zuidec/discostick_cyclic/kicad/z_cyclic.kicad_pcb

## KiCad design kicad/z_cyclic.kicad_pcb (2025-07-11)

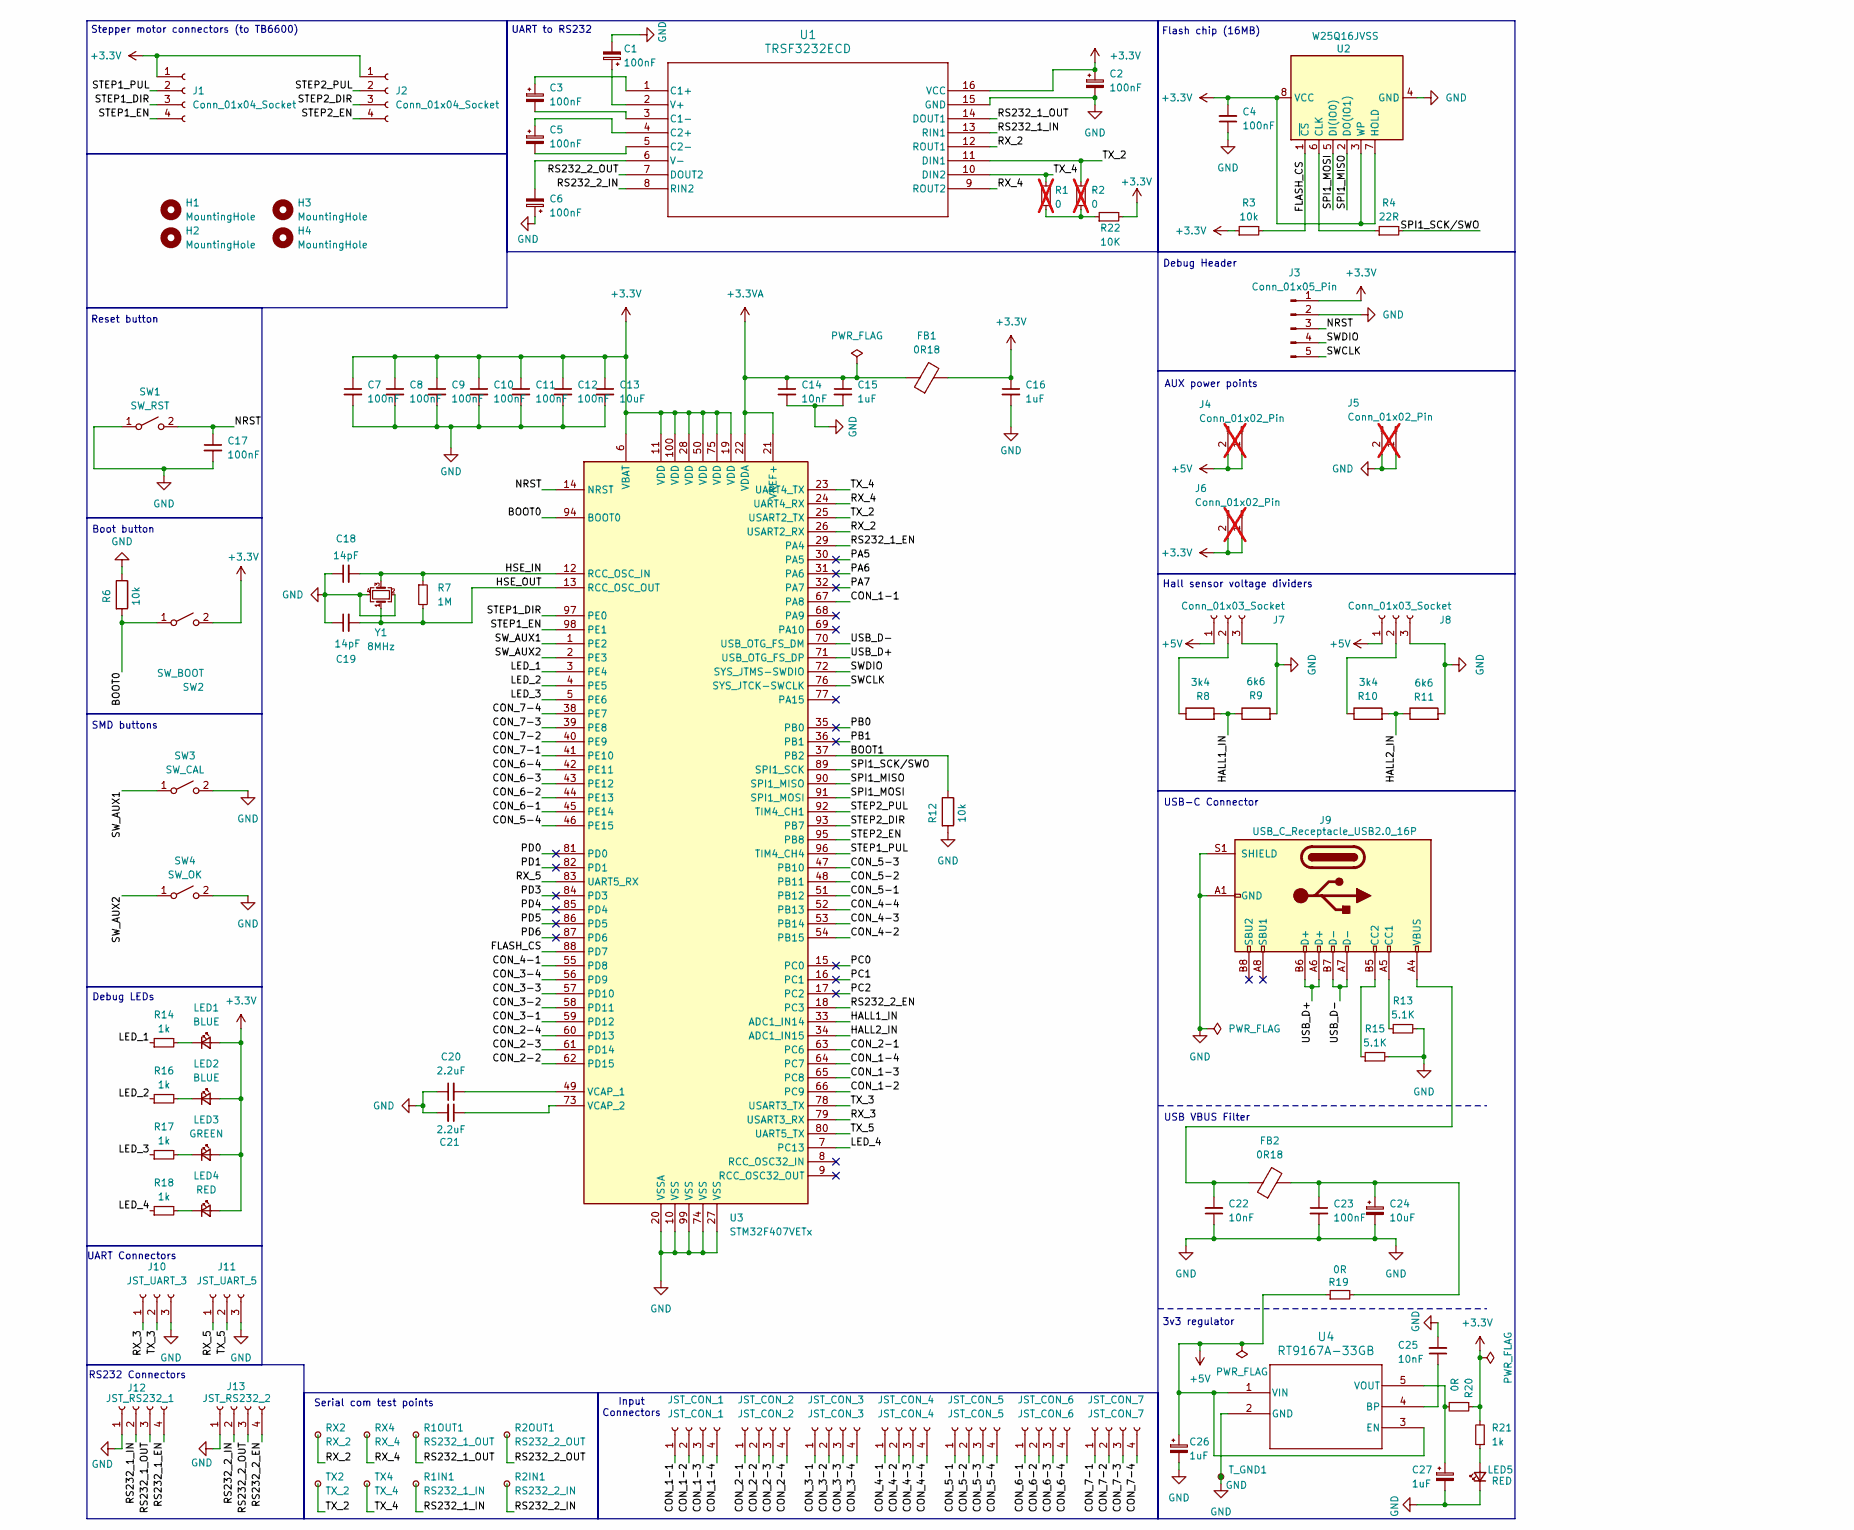
[picture p1: schematic z_cyclic.kicad_sch, distostick_controller, part in row 1, column 1]

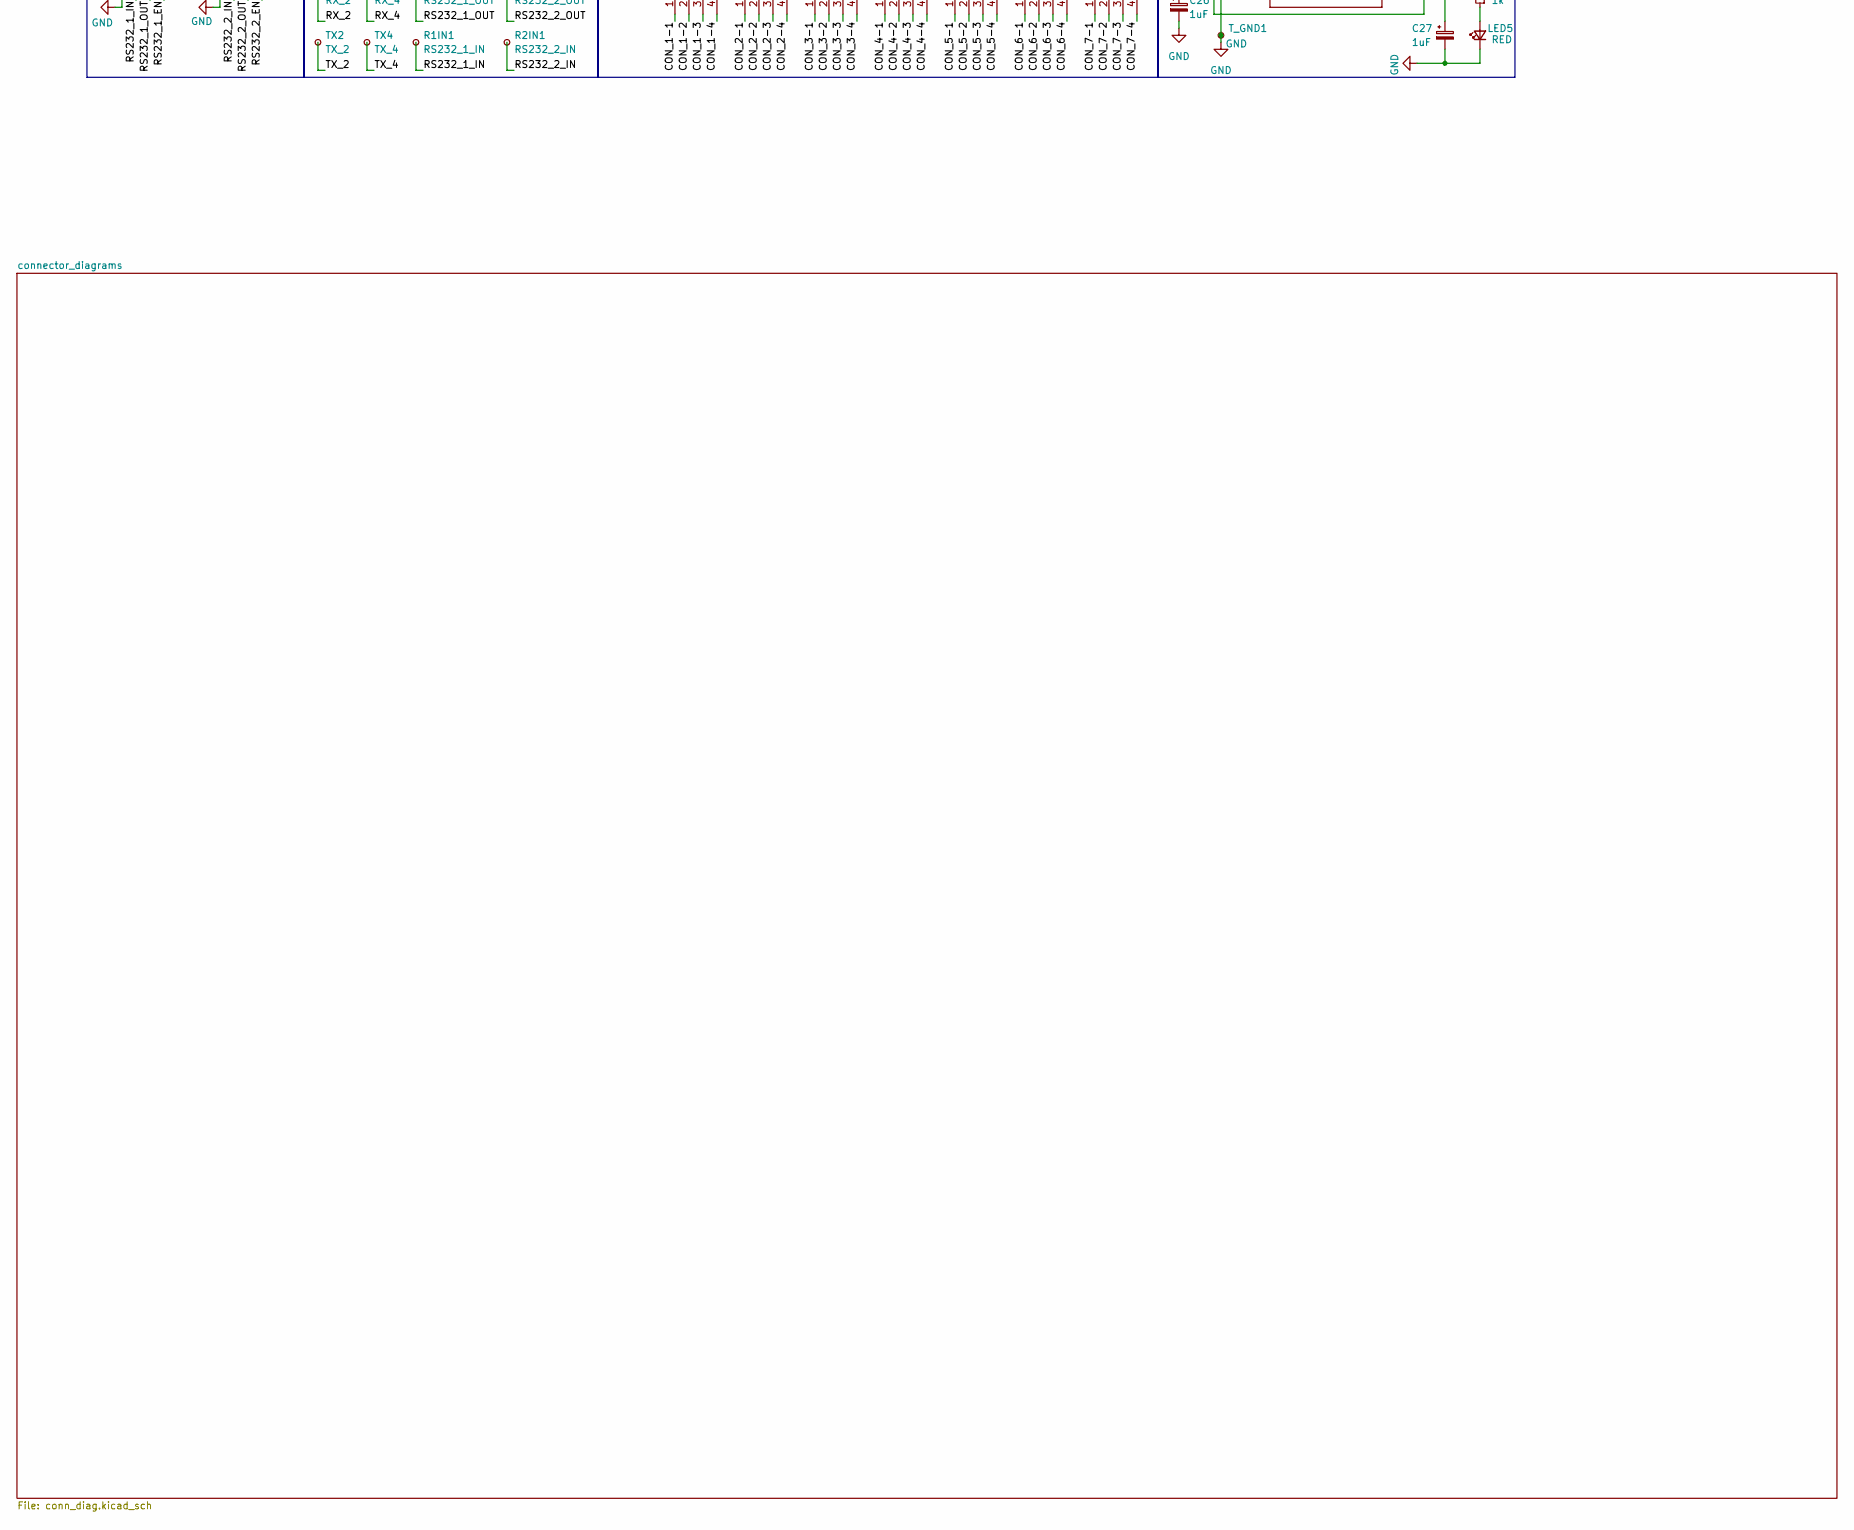
[picture p2: schematic z_cyclic.kicad_sch, distostick_controller, part in row 2, column 1]

Parts:
C1, C2, C3, C4, C5, C6, C7, C8, C9, C10, C11, C12, C17, C23: 100nF; C_0402_1005Metric
C13, C24: 10uF; C_0603_1608Metric
C14, C22, C25: 10nF; C_0402_1005Metric
C15, C16, C26: 1uF; C_0402_1005Metric
C18, C19: 14pF; C_0402_1005Metric
C20, C21: 2.2uF; C_0402_1005Metric
C27: 1uF; C_0603_1608Metric
FB1, FB2: 0R18; R_0805_2012Metric
H1, H2, H3, H4: MountingHole; MountingHole_3.2mm_M3
J1, J2: Conn_01x04_Socket; JST_EH_B4B-EH-A_1x04_P2.50mm_Vertical
J3: Conn_01x05_Pin; PinHeader_1x05_P2.54mm_Vertical
J4, J5, J6: Conn_01x02_Pin; PinSocket_1x02_P2.54mm_Vertical; not fitted
J7, J8: Conn_01x03_Socket; JST_EH_B3B-EH-A_1x03_P2.50mm_Vertical
J9: USB_C_Receptacle_USB2.0_16P; USB_C_Receptacle_G-Switch_GT-USB-7010ASV
J10: JST_UART_3; JST_EH_B3B-EH-A_1x03_P2.50mm_Vertical
J11: JST_UART_5; JST_EH_B3B-EH-A_1x03_P2.50mm_Vertical
J12: JST_RS232_1; JST_EH_B4B-EH-A_1x04_P2.50mm_Vertical
J13: JST_RS232_2; JST_EH_B4B-EH-A_1x04_P2.50mm_Vertical
JST_CON_1: JST_CON_1; JST_EH_B4B-EH-A_1x04_P2.50mm_Vertical
JST_CON_2: JST_CON_2; JST_EH_B4B-EH-A_1x04_P2.50mm_Vertical
JST_CON_3: JST_CON_3; JST_EH_B4B-EH-A_1x04_P2.50mm_Vertical
JST_CON_4: JST_CON_4; JST_EH_B4B-EH-A_1x04_P2.50mm_Vertical
JST_CON_5: JST_CON_5; JST_EH_B4B-EH-A_1x04_P2.50mm_Vertical
JST_CON_6: JST_CON_6; JST_EH_B4B-EH-A_1x04_P2.50mm_Vertical
JST_CON_7: JST_CON_7; JST_EH_B4B-EH-A_1x04_P2.50mm_Vertical
LED1, LED2: BLUE; LED_0402_1005Metric
LED3: GREEN; LED_0402_1005Metric
LED4, LED5: RED; LED_0402_1005Metric
R1, R2: 0; R_0805_2012Metric_Pad1.20x1.40mm_HandSolder; not fitted
R1IN1: RS232_1_IN; TestPoint_Pad_D1.0mm
R1OUT1: RS232_1_OUT; TestPoint_Pad_D1.0mm
R2IN1: RS232_2_IN; TestPoint_Pad_D1.0mm
R2OUT1: RS232_2_OUT; TestPoint_Pad_D1.0mm
R3, R6, R12: 10k; R_0402_1005Metric
R4: 22R; R_0402_1005Metric
R7: 1M; R_0402_1005Metric
R8, R10: 3k4; R_0402_1005Metric
R9, R11: 6k6; R_0402_1005Metric
R13, R15: 5.1K; R_0402_1005Metric
R14, R16, R17, R18, R21: 1k; R_0402_1005Metric
R19, R20: 0R; SolderJumper-2_P1.3mm_Open_TrianglePad1.0x1.5mm
R22: 10K; R_0402_1005Metric
RX2: RX_2; TestPoint_Pad_D1.0mm
RX4: RX_4; TestPoint_Pad_D1.0mm
SW1: SW_RST; SW_SPST_B3U-1000P; PARTREV B
SW2: SW_BOOT; SW_SPST_B3U-1000P; PARTREV B
SW3: SW_CAL; SW_SPST_B3U-1000P; PARTREV B
SW4: SW_OK; SW_SPST_B3U-1000P; PARTREV B
TX2: TX_2; TestPoint_Pad_D1.0mm
TX4: TX_4; TestPoint_Pad_D1.0mm
T_GND1: GND; TestPoint_Pad_1.5x1.5mm
U1: TRSF3232ECD; D16
U2: W25Q16JVSS; SOIC-8_5.23x5.23mm_P1.27mm
U3: STM32F407VETx; LQFP-100_14x14mm_P0.5mm
U4: RT9167A-33GB; SOIC_A-33GB_RIT
Y1: 8MHz; Crystal_SMD_3225-4Pin_3.2x2.5mm

Connections:
+3.3V: C2.1, C4.2, C7.1, C8.1, C9.1, C10.1, C11.1, C12.1, C13.1, C16.1, FB1.2, J1.1, J2.1, J3.1, J6.1, J6.2, LED1.2 (A), LED2.2 (A), LED3.2 (A), LED4.2 (A), R3.1, R20.1, R21.2, R22.2, SW2.2 (B), U1.16 (VCC), U2.3 (WP), U2.7 (HOLD), U2.8 (VCC), U3.6 (VBAT), U3.11 (VDD), U3.19 (VDD), U3.28 (VDD), U3.50 (VDD), U3.75 (VDD), U3.100 (VDD)
+3.3VA: C14.1, C15.1, FB1.1, U3.21 (VREF+), U3.22 (VDDA)
+5V: C26.1, J4.1, J4.2, J7.1, J8.1, R19.1, U4.1 (VIN), U4.3 (EN)
/BOOT0: R6.2, SW2.1 (A), U3.94 (BOOT0)
/BOOT1: R12.1, U3.37 (PB2)
/CON_1-1: JST_CON_1.1, U3.67 (PA8)
/CON_1-2: JST_CON_1.2, U3.66 (PC9)
/CON_1-3: JST_CON_1.3, U3.65 (PC8)
/CON_1-4: JST_CON_1.4, U3.64 (PC7)
/CON_2-1: JST_CON_2.1, U3.63 (PC6)
/CON_2-2: JST_CON_2.2, U3.62 (PD15)
/CON_2-3: JST_CON_2.3, U3.61 (PD14)
/CON_2-4: JST_CON_2.4, U3.60 (PD13)
/CON_3-1: JST_CON_3.1, U3.59 (PD12)
/CON_3-2: JST_CON_3.2, U3.58 (PD11)
/CON_3-3: JST_CON_3.3, U3.57 (PD10)
/CON_3-4: JST_CON_3.4, U3.56 (PD9)
/CON_4-1: JST_CON_4.1, U3.55 (PD8)
/CON_4-2: JST_CON_4.2, U3.54 (PB15)
/CON_4-3: JST_CON_4.3, U3.53 (PB14)
/CON_4-4: JST_CON_4.4, U3.52 (PB13)
/CON_5-1: JST_CON_5.1, U3.51 (PB12)
/CON_5-2: JST_CON_5.2, U3.48 (PB11)
/CON_5-3: JST_CON_5.3, U3.47 (PB10)
/CON_5-4: JST_CON_5.4, U3.46 (PE15)
/CON_6-1: JST_CON_6.1, U3.45 (PE14)
/CON_6-2: JST_CON_6.2, U3.44 (PE13)
/CON_6-3: JST_CON_6.3, U3.43 (PE12)
/CON_6-4: JST_CON_6.4, U3.42 (PE11)
/CON_7-1: JST_CON_7.1, U3.41 (PE10)
/CON_7-2: JST_CON_7.2, U3.40 (PE9)
/CON_7-3: JST_CON_7.3, U3.39 (PE8)
/CON_7-4: JST_CON_7.4, U3.38 (PE7)
/FLASH_CS: R3.2, U2.1 (~CS), U3.88 (PD7)
/HALL1_IN: R8.2, R9.1, U3.33 (ADC1_IN14)
/HALL2_IN: R10.2, R11.1, U3.34 (ADC1_IN15)
/HSE_IN: C18.2, R7.1, U3.12 (RCC_OSC_IN), Y1.3
/HSE_OUT: C19.2, R7.2, U3.13 (RCC_OSC_OUT), Y1.1
/LED_1: R14.1, U3.3 (PE4)
/LED_2: R16.1, U3.4 (PE5)
/LED_3: R17.1, U3.5 (PE6)
/LED_4: R18.1, U3.7 (PC13)
/NRST: C17.1, J3.3, SW1.2 (B), U3.14 (NRST)
/PA5: U3.30 (PA5)
/PA6: U3.31 (PA6)
/PA7: U3.32 (PA7)
/PB0: U3.35 (PB0)
/PB1: U3.36 (PB1)
/PC0: U3.15 (PC0)
/PC1: U3.16 (PC1)
/PC2: U3.17 (PC2)
/PD0: U3.81 (PD0)
/PD1: U3.82 (PD1)
/PD3: U3.84 (PD3)
/PD4: U3.85 (PD4)
/PD5: U3.86 (PD5)
/PD6: U3.87 (PD6)
/RS232_1_EN: J12.4, U3.29 (PA4)
/RS232_1_IN: J12.2, R1IN1.1, U1.13 (RIN1)
/RS232_1_OUT: J12.3, R1OUT1.1, U1.14 (DOUT1)
/RS232_2_EN: J13.4, U3.18 (PC3)
/RS232_2_IN: J13.2, R2IN1.1, U1.8 (RIN2)
/RS232_2_OUT: J13.3, R2OUT1.1, U1.7 (DOUT2)
/RX_2: RX2.1, U1.12 (ROUT1), U3.26 (USART2_RX)
/RX_3: J10.1, U3.79 (USART3_RX)
/RX_4: RX4.1, U1.9 (ROUT2), U3.24 (UART4_RX)
/RX_5: J11.1, U3.83 (UART5_RX)
/SPI1_MISO: U2.2 (DO(IO1)), U3.90 (SPI1_MISO)
/SPI1_MOSI: U2.5 (DI(IO0)), U3.91 (SPI1_MOSI)
/SPI1_SCK/SWO: R4.2, U3.89 (SPI1_SCK)
/STEP1_DIR: J1.3, U3.97 (PE0)
/STEP1_EN: J1.4, U3.98 (PE1)
/STEP1_PUL: J1.2, U3.96 (TIM4_CH4)
/STEP2_DIR: J2.3, U3.93 (PB7)
/STEP2_EN: J2.4, U3.95 (PB8)
/STEP2_PUL: J2.2, U3.92 (TIM4_CH1)
/SWCLK: J3.5, U3.76 (SYS_JTCK-SWCLK)
/SWDIO: J3.4, U3.72 (SYS_JTMS-SWDIO)
/SW_AUX1: SW3.1 (A), U3.1 (PE2)
/SW_AUX2: SW4.1 (A), U3.2 (PE3)
/TX_2: R2.1, TX2.1, U1.11 (DIN1), U3.25 (USART2_TX)
/TX_3: J10.2, U3.78 (USART3_TX)
/TX_4: R1.1, TX4.1, U1.10 (DIN2), U3.23 (UART4_TX)
/TX_5: J11.2, U3.80 (UART5_TX)
/USB_D+: J9.A6 (D+), J9.B6 (D+), U3.71 (USB_OTG_FS_DP)
/USB_D-: J9.A7 (D-), J9.B7 (D-), U3.70 (USB_OTG_FS_DM)
GND: C1.2, C2.2, C4.1, C6.1, C7.2, C8.2, C9.2, C10.2, C11.2, C12.2, C13.2, C14.2, C15.2, C16.2, C17.2, C18.1, C19.1, C20.1, C21.2, C22.1, C23.2, C24.2, C25.2, C26.2, C27.2, J3.2, J5.1, J5.2, J7.3, J8.3, J9.A1 (GND), J9.A12 (GND), J9.B1 (GND), J9.B12 (GND), J9.S1 (SHIELD), J10.3, J11.3, J12.1, J13.1, LED5.1 (K), R6.1, R9.2, R11.2, R12.2, R13.2, R15.2, SW1.1 (A), SW3.2 (B), SW4.2 (B), T_GND1.1, U1.15 (GND), U2.4 (GND), U3.10 (VSS), U3.20 (VSSA), U3.27 (VSS), U3.74 (VSS), U3.99 (VSS), U4.2 (GND), Y1.2, Y1.4
unnamed: C22.2, FB2.1, J9.A4 (VBUS), J9.A9 (VBUS), J9.B4 (VBUS), J9.B9 (VBUS)
unnamed: C23.1, C24.1, FB2.2, R19.2
unnamed: J7.2, R8.1
unnamed: J8.2, R10.1
unnamed: J9.A5 (CC1), R13.1
unnamed: J9.B5 (CC2), R15.1
unnamed: LED1.1 (K), R14.2
unnamed: LED2.1 (K), R16.2
unnamed: LED3.1 (K), R17.2
unnamed: LED4.1 (K), R18.2
unnamed: LED5.2 (A), R21.1
unnamed: R1.2, R2.2, R22.1
unnamed: C3.1, U1.1 (C1+)
unnamed: C3.2, U1.3 (C1-)
unnamed: C5.1, U1.4 (C2+)
unnamed: C5.2, U1.5 (C2-)
unnamed: C1.1, U1.2 (V+)
unnamed: C6.2, U1.6 (V-)
unnamed: R4.1, U2.6 (CLK)
unnamed: C20.2, U3.49 (VCAP_1)
unnamed: C21.1, U3.73 (VCAP_2)
unnamed: C25.1, U4.4 (BP)
unnamed: C27.1, R20.2, U4.5 (VOUT)

Notes on the sheet:
Stepper motor connectors (to TB6600)
Reset button
RS232 Connectors
SMD buttons
Boot button
UART to RS232
Serial com test points
Flash chip (16MB)
AUX power points
3v3 regulator
USB VBUS Filter
USB-C Connector
Debug LEDs
UART Connectors
Input Connectors
Hall sensor voltage dividers
Debug Header

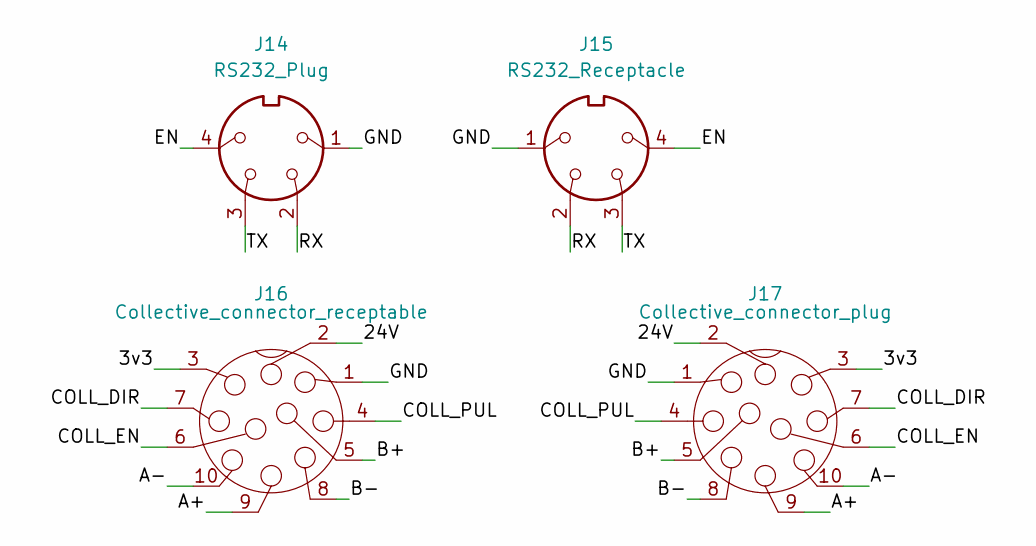
[picture p3: schematic conn_diag.kicad_sch]

Parts:
J14: RS232_Plug
J15: RS232_Receptacle
J16: Collective_connector_receptable
J17: Collective_connector_plug

Connections:
unnamed: J14.1, J15.1, J16.1, J17.1
unnamed: J14.2, J15.2
unnamed: J14.3, J15.3
unnamed: J14.4, J15.4
unnamed: J16.2, J17.2
unnamed: J16.3, J17.3
unnamed: J16.4, J17.4
unnamed: J16.5, J17.5
unnamed: J16.6, J17.6
unnamed: J16.7, J17.7
unnamed: J16.8, J17.8
unnamed: J16.9, J17.9
unnamed: J16.10, J17.10

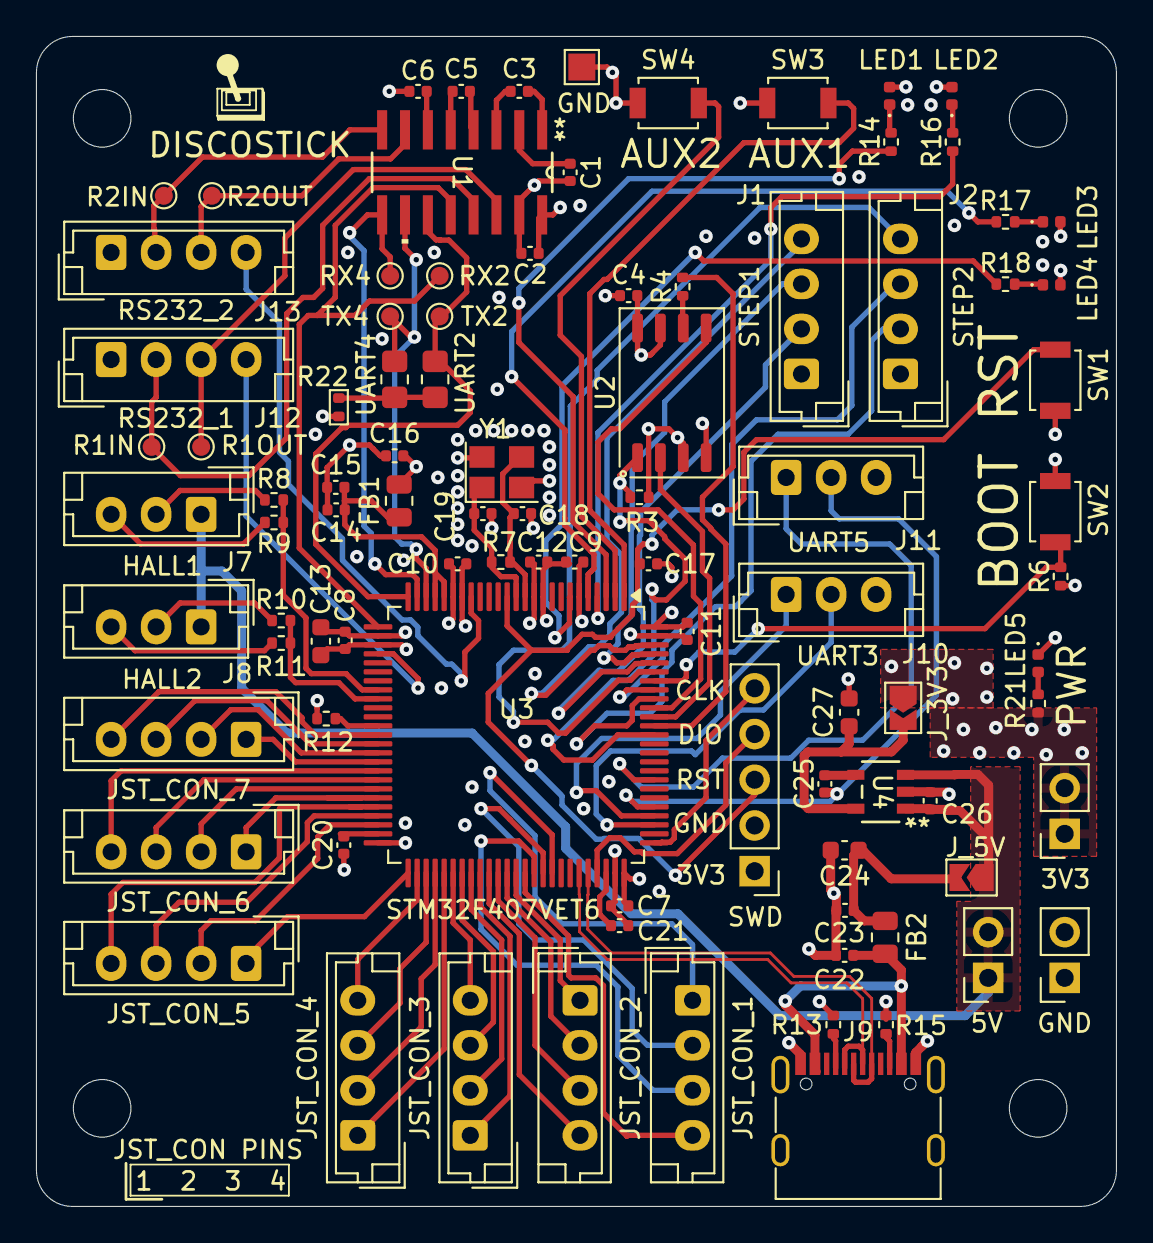
[picture p4: board z_cyclic.kicad_pcb from above]

Board: 4 copper layers, 60.0 x 65.0 mm, 97 parts (0 on the bottom side), 96 nets.
