zuidec/discostick_cyclic/kicad/backup.z_cyclic.kicad_pcb

## KiCad design kicad/backup.z_cyclic.kicad_pcb (2025-07-11)

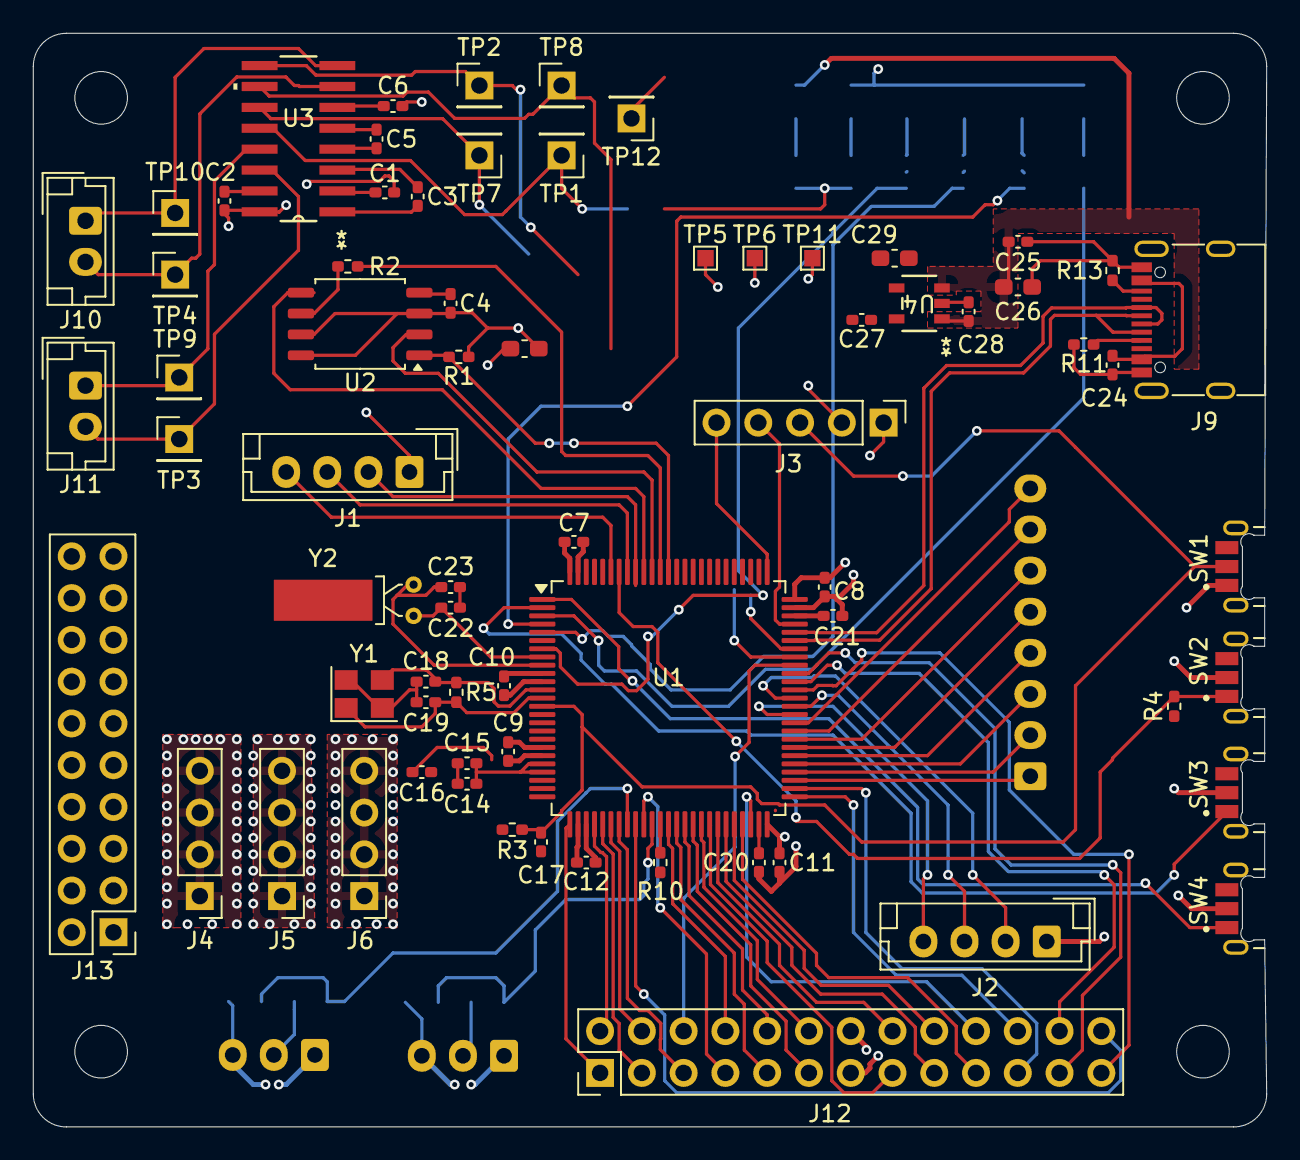
[picture p5: board backup.z_cyclic.kicad_pcb from above]

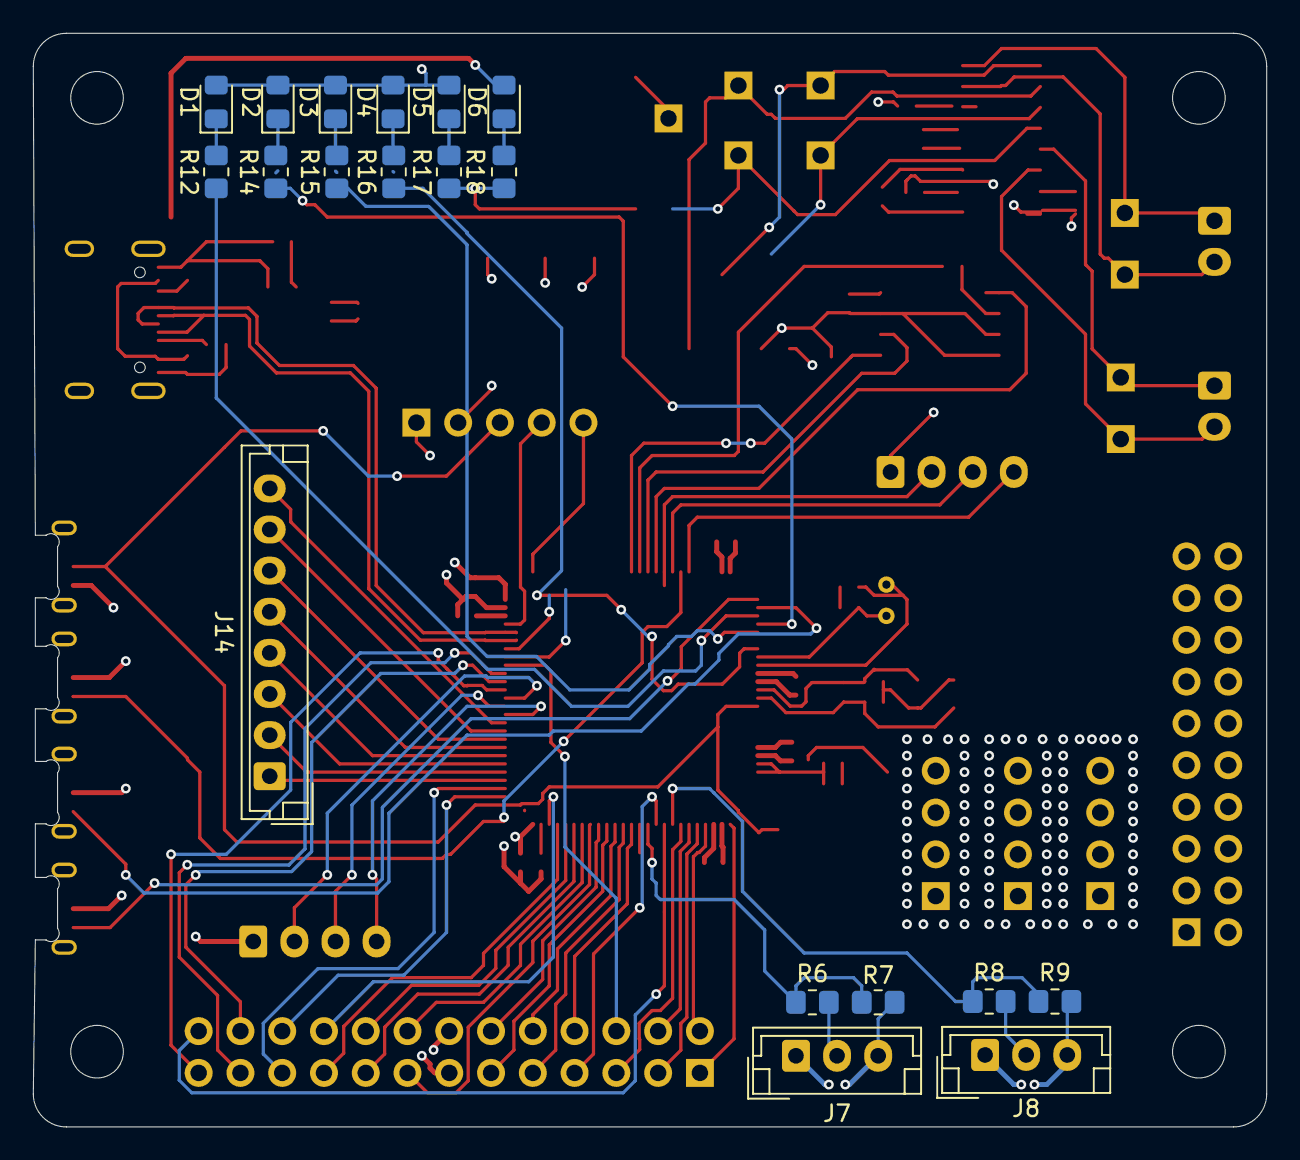
[picture p6: board backup.z_cyclic.kicad_pcb from below]

Board: 4 copper layers, 75.0 x 66.5 mm, 93 parts (19 on the bottom side), 112 nets.

Parts:
C1, C2, C3, C4, C5, C6, C7, C8, C9, C10, C11, C12, C17, C25: 100nF; C_0402_1005Metric_Pad0.74x0.62mm_HandSolder
C13, C26: 10uF; C_0603_1608Metric_Pad1.08x0.95mm_HandSolder
C14, C24: 10nF; C_0402_1005Metric_Pad0.74x0.62mm_HandSolder
C15, C16, C28: 1uF; C_0402_1005Metric_Pad0.74x0.62mm_HandSolder
C18, C19: 14pF; C_0402_1005Metric_Pad0.74x0.62mm_HandSolder
C20, C21: 2.2uF; C_0402_1005Metric_Pad0.74x0.62mm_HandSolder
C22, C23: 1.5pF; C_0402_1005Metric_Pad0.74x0.62mm_HandSolder
C27: 10uF; C_0402_1005Metric_Pad0.74x0.62mm_HandSolder
C29: 1uF; C_0603_1608Metric_Pad1.08x0.95mm_HandSolder
D1, D2: BLUE; LED_0805_2012Metric_Pad1.15x1.40mm_HandSolder
D3: GREEN; LED_0805_2012Metric_Pad1.15x1.40mm_HandSolder
D4, D5, D6: RED; LED_0805_2012Metric_Pad1.15x1.40mm_HandSolder
H1, H2, H3, H4: MountingHole; MountingHole_3.2mm_M3
J1, J2: Conn_01x04_Socket; JST_EH_B4B-EH-A_1x04_P2.50mm_Vertical
J3: Conn_01x05_Pin; PinHeader_1x05_P2.54mm_Vertical
J4, J5, J6: Conn_01x04_Socket; PinHeader_1x04_P2.54mm_Vertical
J7, J8: Conn_01x03_Socket; JST_EH_B3B-EH-A_1x03_P2.50mm_Vertical
J9: USB_C_Receptacle_USB2.0_16P; USB_C_Receptacle_G-Switch_GT-USB-7010ASV
J10, J11: Conn_01x02_Socket; JST_EH_B2B-EH-A_1x02_P2.50mm_Vertical
J12: Conn_02x13_Counter_Clockwise; PinHeader_2x13_P2.54mm_Vertical
J13: Conn_02x10_Counter_Clockwise; PinHeader_2x10_P2.54mm_Vertical
J14: Conn_01x08_Socket; JST_EH_B8B-EH-A_1x08_P2.50mm_Vertical
R1, R4, R10: 10k; R_0402_1005Metric_Pad0.72x0.64mm_HandSolder
R2: 22R; R_0402_1005Metric_Pad0.72x0.64mm_HandSolder
R3: 10K; R_0402_1005Metric_Pad0.72x0.64mm_HandSolder
R5: 1M; R_0402_1005Metric_Pad0.72x0.64mm_HandSolder
R6, R8: 3k4; R_0805_2012Metric_Pad1.20x1.40mm_HandSolder
R7, R9: 6k6; R_0805_2012Metric_Pad1.20x1.40mm_HandSolder
R11, R13: 5.1K; R_0402_1005Metric_Pad0.72x0.64mm_HandSolder
R12, R14, R15, R16, R17, R18: 1k; R_0805_2012Metric_Pad1.20x1.40mm_HandSolder
SW1: SW_RST; SW_PTS847MM160LSMTR2_LFS
SW2: SW_BOOT; SW_PTS847MM160LSMTR2_LFS
SW3: SW_CAL; SW_PTS847MM160LSMTR2_LFS
SW4: SW_OK; SW_PTS847MM160LSMTR2_LFS
TP1: RX_1; PinHeader_1x01_P2.54mm_Vertical
TP2: RX_3; PinHeader_1x01_P2.54mm_Vertical
TP3: RS232_1_OUT; PinHeader_1x01_P2.54mm_Vertical
TP4: RS232_2_OUT; PinHeader_1x01_P2.54mm_Vertical
TP5: 3V3; TestPoint_Pad_1.0x1.0mm
TP6: 5V; TestPoint_Pad_1.0x1.0mm
TP7: TX_1; PinHeader_1x01_P2.54mm_Vertical
TP8: TX_3; PinHeader_1x01_P2.54mm_Vertical
TP9: RS232_1_IN; PinHeader_1x01_P2.54mm_Vertical
TP10: RS232_2_IN; PinHeader_1x01_P2.54mm_Vertical
TP11: GND; TestPoint_Pad_1.0x1.0mm
TP12: GND; PinHeader_1x01_P2.54mm_Vertical
U1: STM32F407VETx; LQFP-100_14x14mm_P0.5mm
U2: W25Q16JVSS; SOIC-8_5.23x5.23mm_P1.27mm
U3: TRSF3232ECD; D16
U4: RT9167A-33GB; SOIC_A-33GB_RIT
Y1: 8MHz; Crystal_SMD_3225-4Pin_3.2x2.5mm
Y2: 32.768K; Crystal_DS26_D2.0mm_L6.0mm_Horizontal_1EP_style1

Connections:
+3.3V: C2.1, C4.2, C7.1, C8.1, C9.1, C10.1, C11.1, C12.1, C13.1, C16.1, C29.1, D1.2 (A), D2.2 (A), D3.2 (A), D4.2 (A), D5.2 (A), J1.1, J2.1, J3.1, J6.1, J6.2, J6.3, J6.4, J12.13, J13.10, R1.1, R3.1, SW2.2, TP5.1, U1.6 (VBAT), U1.11 (VDD), U1.19 (VDD), U1.28 (VDD), U1.50 (VDD), U1.75 (VDD), U1.100 (VDD), U2.3 (WP), U2.7 (HOLD), U2.8 (VCC), U3.16 (VCC), U4.4 (VOUT)
+3.3VA: C14.1, C15.1, U1.21 (VREF+), U1.22 (VDDA)
+5V: C25.1, C26.1, C28.1, D6.2 (A), J4.1, J4.2, J4.3, J4.4, J7.1, J8.1, TP6.1, U4.1 (VIN), U4.3 (EN)
/AP_REL: J14.8, U1.60 (PD13)
/BOOT0: R4.2, SW2.1, U1.94 (BOOT0)
/BOOT1: R10.1, U1.37 (PB2)
/CARGO_REL: J14.7, U1.59 (PD12)
/CD_REL: J14.5, U1.57 (PD10)
/FLASH_CS: R1.2, U1.88 (PD7), U2.1 (~CS)
/HAT_D: J14.1, U1.53 (PB14)
/HAT_L: J14.4, U1.56 (PD9)
/HAT_R: J14.3, U1.55 (PD8)
/HAT_U: J14.2, U1.54 (PB15)
/HSE_IN: C18.2, R5.1, U1.12 (RCC_OSC_IN), Y1.3
/HSE_OUT: C19.2, R5.2, U1.13 (RCC_OSC_OUT), Y1.1
/ICS_SW: J14.6, U1.58 (PD11)
/LED_AUX: R16.1, U1.7 (PC13)
/LED_PITCH: R14.1, U1.4 (PE5)
/LED_ROLL: R12.1, U1.3 (PE4)
/LED_STATUS: R15.1, U1.5 (PE6)
/NRST: C17.1, J3.3, R3.2, SW1.2, U1.14 (NRST)
/PA0: J13.5, U1.23 (PA0)
/PA1: J13.6, U1.24 (PA1)
/PA2: J13.7, U1.25 (PA2)
/PA3: J12.1, U1.26 (PA3)
/PA4: J12.2, U1.29 (PA4)
/PA5: J12.3, U1.30 (PA5)
/PA6: J12.4, U1.31 (PA6)
/PA7: J12.5, U1.32 (PA7)
/PA8: J12.6, U1.67 (PA8)
/PB0: J12.7, U1.35 (PB0)
/PB9: J13.20, U1.96 (PB9)
/PB10: J12.19, U1.47 (PB10)
/PB11: J12.20, U1.48 (PB11)
/PB12: J12.22, U1.51 (PB12)
/PB13: J12.21, U1.52 (PB13)
/PC0: J13.1, U1.15 (PC0)
/PC1: J13.2, U1.16 (PC1)
/PC2: J13.3, U1.17 (PC2)
/PC3: J13.4, U1.18 (PC3)
/PC5: J12.26, U1.34 (PC5)
/PC7: J12.25, U1.64 (PC7)
/PC8: J12.24, U1.65 (PC8)
/PC9: J12.23, U1.66 (PC9)
/PC12: J13.12, U1.80 (PC12)
/PD0: J13.13, U1.81 (PD0)
/PD1: J13.14, U1.82 (PD1)
/PD2: J13.15, U1.83 (PD2)
/PD3: J13.16, U1.84 (PD3)
/PD4: J13.17, U1.85 (PD4)
/PD5: J13.18, U1.86 (PD5)
/PD6: J13.19, U1.87 (PD6)
/PE0: J13.8, U1.97 (PE0)
/PE1: J13.9, U1.98 (PE1)
/PE7: J12.8, U1.38 (PE7)
/PE8: J12.9, U1.39 (PE8)
/PE9: J12.10, U1.40 (PE9)
/PE10: J12.11, U1.41 (PE10)
/PE11: J12.12, U1.42 (PE11)
/PE12: J12.15, U1.43 (PE12)
/PE13: J12.16, U1.44 (PE13)
/PE14: J12.17, U1.45 (PE14)
/PE15: J12.18, U1.46 (PE15)
/PITCH_DIR: J1.3, U1.93 (PB7)
/PITCH_EN: J1.4, U1.95 (PB8)
/PITCH_IN: R6.2, R7.1, U1.36 (ADC1_IN9)
/PITCH_PUL: J1.2, U1.92 (TIM4_CH1)
/ROLL_DIR: J2.3, U1.62 (PD15)
/ROLL_EN: J2.4, U1.61 (PD14)
/ROLL_IN: R8.2, R9.1, U1.33 (ADC1_IN14)
/ROLL_PUL: J2.2, U1.63 (TIM3_CH1)
/RS232_1_IN: J11.1, TP9.1, U3.13 (RIN1)
/RS232_1_OUT: J11.2, TP3.1, U3.14 (DOUT1)
/RS232_2_IN: J10.1, TP10.1, U3.8 (RIN2)
/RS232_2_OUT: J10.2, TP4.1, U3.7 (DOUT2)
/RX_1: TP1.1, U1.69 (USART1_RX), U3.12 (ROUT1)
/RX_3: TP2.1, U1.79 (USART3_RX), U3.9 (ROUT2)
/SPI1_MISO: U1.90 (SPI1_MISO), U2.2 (DO(IO1))
/SPI1_MOSI: U1.91 (SPI1_MOSI), U2.5 (DI(IO0))
/SPI1_SCK/SWO: R2.2, U1.89 (SPI1_SCK)
/SWCLK: J3.5, U1.76 (SYS_JTCK-SWCLK)
/SWDIO: J3.4, U1.72 (SYS_JTMS-SWDIO)
/SW_CAL: SW3.1, U1.2 (PE3)
/SW_OK: SW4.1, U1.1 (PE2)
/TX_1: TP7.1, U1.68 (USART1_TX), U3.11 (DIN1)
/TX_3: TP8.1, U1.78 (USART3_TX), U3.10 (DIN2)
/USB_D+: J9.A6 (D+), J9.B6 (D+), U1.71 (USB_OTG_FS_DP)
/USB_D-: J9.A7 (D-), J9.B7 (D-), U1.70 (USB_OTG_FS_DM)
GND: C1.2, C2.2, C4.1, C6.1, C7.2, C8.2, C9.2, C10.2, C11.2, C12.2, C13.2, C14.2, C15.2, C16.2, C17.2, C18.1, C19.1, C20.1, C21.2, C22.2, C23.2, C24.1, C25.2, C26.2, C27.2, C28.2, C29.2, J3.2, J5.1, J5.2, J5.3, J5.4, J7.3, J8.3, J9.A1 (GND), J9.A12 (GND), J9.B1 (GND), J9.B12 (GND), J9.S1 (SHIELD), J12.14, J13.11, R4.1, R7.2, R9.2, R10.2, R11.2, R13.2, R17.1, R18.2, SW1.1, SW3.2, SW4.2, TP11.1, TP12.1, U1.10 (VSS), U1.20 (VSSA), U1.27 (VSS), U1.74 (VSS), U1.99 (VSS), U2.4 (GND), U3.15 (GND), U4.2 (GND), Y1.2, Y1.4
unnamed: C24.2, J9.A4 (VBUS), J9.A9 (VBUS), J9.B4 (VBUS), J9.B9 (VBUS)
unnamed: D1.1 (K), R12.2
unnamed: D2.1 (K), R14.2
unnamed: D3.1 (K), R15.2
unnamed: D4.1 (K), R16.2
unnamed: D5.1 (K), R17.2
unnamed: D6.1 (K), R18.1
unnamed: J7.2, R6.1
unnamed: J8.2, R8.1
unnamed: J9.A5 (CC1), R11.1
unnamed: J9.B5 (CC2), R13.1
unnamed: C22.1, U1.8 (RCC_OSC32_IN), Y2.2
unnamed: C23.1, U1.9 (RCC_OSC32_OUT), Y2.1
unnamed: C20.2, U1.49 (VCAP_1)
unnamed: C21.1, U1.73 (VCAP_2)
unnamed: R2.1, U2.6 (CLK)
unnamed: C3.1, U3.1 (C1+)
unnamed: C3.2, U3.3 (C1-)
unnamed: C5.1, U3.4 (C2+)
unnamed: C5.2, U3.5 (C2-)
unnamed: C1.1, U3.2 (V+)
unnamed: C6.2, U3.6 (V-)
unnamed: C27.1, U4.5 (BP)
