zuidec/discostick_cyclic/Core/Inc/special_hid_conf.h

/*
 * special_hid_conf.h
 *
 *  Created on: Jul 21, 2025
 *      Author: zuidec
 */

#ifndef INC_SPECIAL_HID_CONF_H_
#define INC_SPECIAL_HID_CONF_H_

#include "main.h"
extern uint8_t ENABLE_USBD_HID_CUSTOM2;

uint8_t is_enabled_hid2(void);
#endif /* INC_SPECIAL_HID_CONF_H_ */
