zuidec/discostick_cyclic/(commit log)

2025-07-20 Now enumerating 2 USB devices
2025-07-21 First working with 2 devices
